grahamshaw1972/TeensyNumPad/README.md

# TeensyNumPad
 Amiga Layout Numpad using Teensy++ 2.0 micro controller. The V1.3 board looks like this when completed and populated with keycaps: 

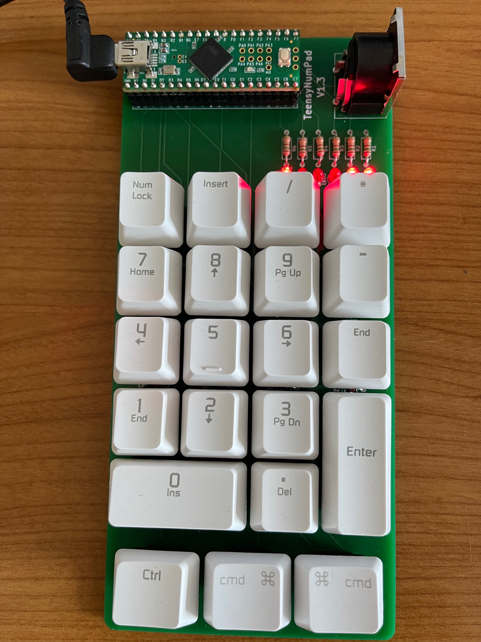
[picture p1: teensyNumPad1_3Assembled.jpg]
