grahamshaw1972/TeensyNumPad/keyboard-layout-editor/keyboard-layout.png

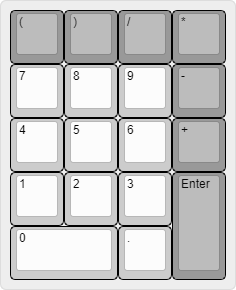
keyboard-layout-editor/keyboard-layout.png
