grahamshaw1972/TeensyNumPad/bom/teensyNumPadBOM.xlsx

Sheet: Mouser
Quantity | Mouser Part Number | References | Value | Footprint
9 | 603-CFR-25JT-52-150R | R1 - R9 | 150 | R_Axial_DIN0207_L6.3mm_D2.5mm_P7.62mm_Horizontal
18 | 512-1N4148 | D1 - D18 | Switching Diode | D_DO-35_SOD27_P7.62mm_Horizontal
1 | 474-DEV-11781 | U1 | Teensy++ 2.0 | D_DO-35_SOD27_P7.62mm_Horizontal
1 | 575-1104764041001000 | U1 | 40 Pin Socket | 40P_2Row_Pitch2.54 mm
9 | 78-TLHK42T1U2 | LED1 - LED9 | Red LED | LED_D3.0mm
21 | 540-MX1A-11NW | MX1 - MX21 | Cherry MX Black | L15.6 mm_W15.6 mm
1 | 806-KCDX-5S-S2 | J1 | 5 Pin Din | KCDX5SS2

Sheet: Other Sources
Quantity | URL | References | Value | Footprint | Notes
1 | https://kbdfans.com/products/cherry-original-pcb-stabilizers | MX16, MX18 | 2u | 2u
1 | https://hobbycomponents.com/connectors/439-01-254mm-40way-sil-turned-pin-m-m-headers-pack-of-5 | U1 | 40 pin | 2 x 20 pin | Cut in half
