grahamshaw1972/TeensyNumPad/teensyNumPadKicad/teensyNumPadKicad.kicad_pcb

## KiCad design teensyNumPadKicad/teensyNumPadKicad.kicad_pcb (2021-06-02)

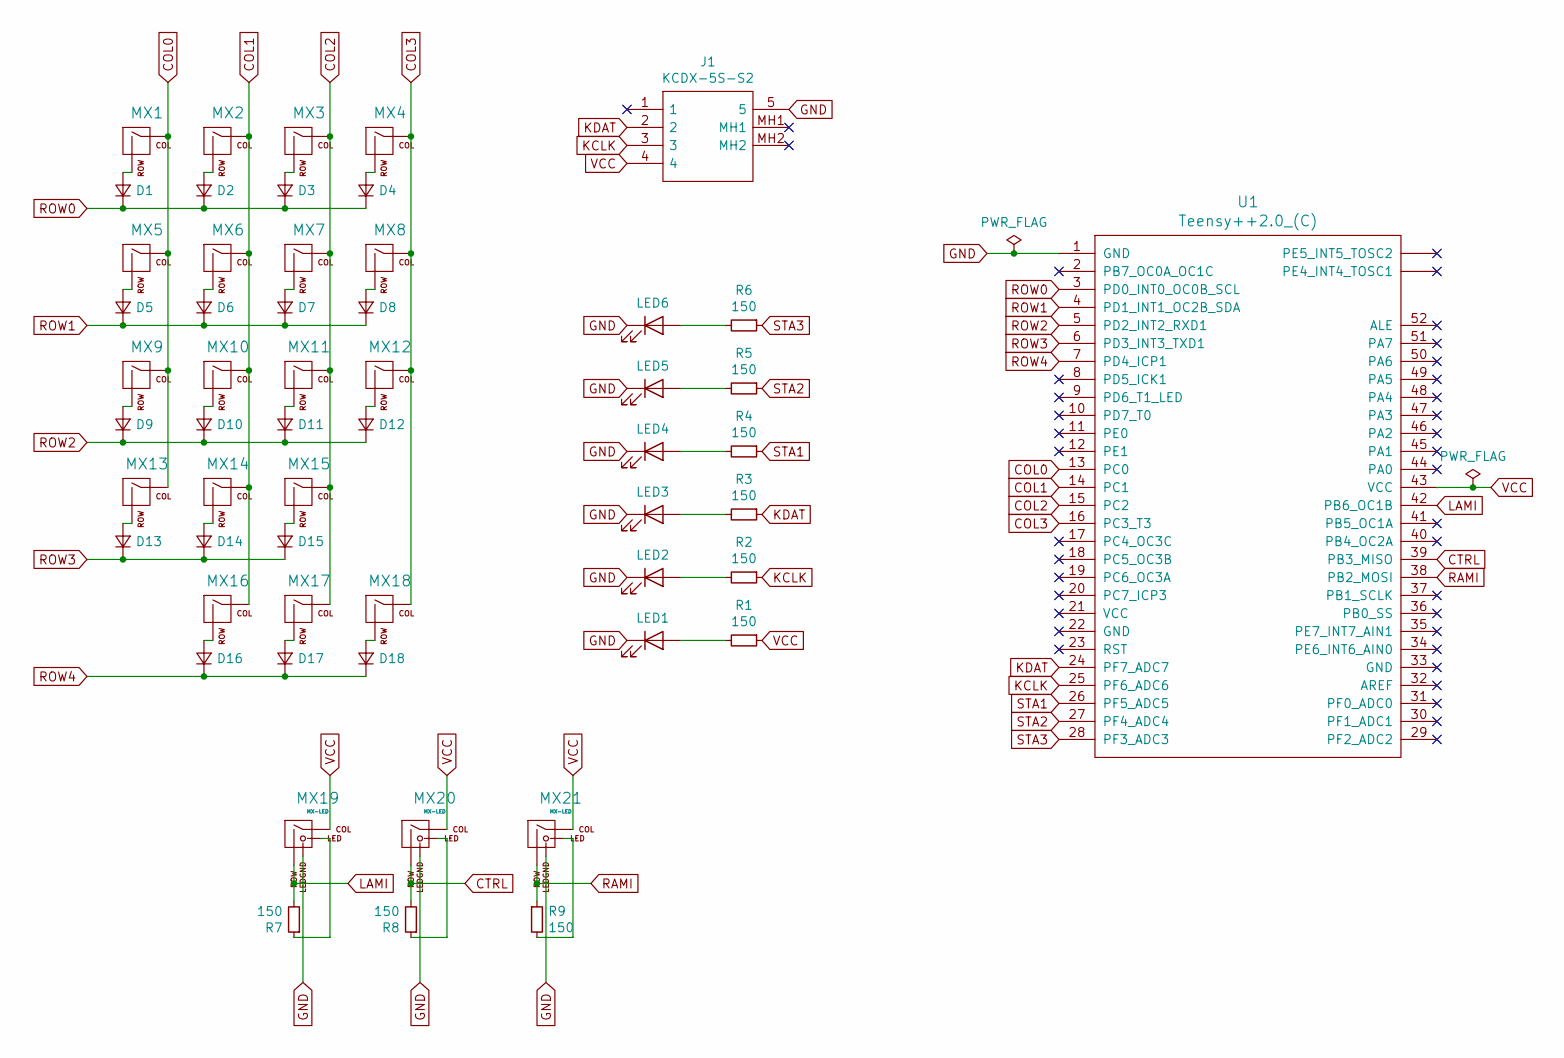
[picture p3: schematic teensyNumPadKicad.sch]

Parts:
D1, D2, D3, D4, D5, D6, D7, D8, D9, D10, D11, D12, D13, D14, D15, D16, D17, D18: D_Small; D_DO-35_SOD27_P7.62mm_Horizontal
J1: KCDX-5S-S2; KCDX5SS2; Manufacturer_Part_Number KCDX-5S-S2
LED1, LED2, LED3, LED4, LED5, LED6: LED; LED_D3.0mm
MX1, MX2, MX3, MX4, MX5, MX6, MX7, MX8, MX9, MX10, MX11, MX12, MX13, MX14, MX15, MX17: MX-NoLED; MX-1U-NoLED
MX16, MX18: MX-NoLED; MX-2U-NoLED
MX19, MX20, MX21: MX-LED; MX-1.25U
R1, R2, R3, R4, R5, R6, R7, R8, R9: 150; R_Axial_DIN0207_L6.3mm_D2.5mm_P10.16mm_Horizontal
U1: Teensy++2.0_(C); Teensy2.0++

Connections:
COL0: MX1.1 (COL), MX5.1 (COL), MX9.1 (COL), MX13.1 (COL), U1.13 (PC0)
COL1: MX2.1 (COL), MX6.1 (COL), MX10.1 (COL), MX14.1 (COL), MX16.1 (COL), U1.14 (PC1)
COL2: MX3.1 (COL), MX7.1 (COL), MX11.1 (COL), MX15.1 (COL), MX17.1 (COL), U1.15 (PC2)
COL3: MX4.1 (COL), MX8.1 (COL), MX12.1 (COL), MX18.1 (COL), U1.16 (PC3_T3)
CTRL: MX20.2 (ROW), R8.2, U1.39 (PB3_MISO)
GND: J1.5, LED1.1 (K), LED2.1 (K), LED3.1 (K), LED4.1 (K), LED5.1 (K), LED6.1 (K), MX19.4 (LEDGND), MX20.4 (LEDGND), MX21.4 (LEDGND), U1.1 (GND)
KCLK: J1.3, R2.1, U1.25 (PF6_ADC6)
KDAT: J1.2, R3.1, U1.24 (PF7_ADC7)
LAMI: MX19.2 (ROW), R7.2, U1.42 (PB6_OC1B)
unnamed: D1.2 (A), MX1.2 (ROW)
unnamed: D2.2 (A), MX2.2 (ROW)
unnamed: D3.2 (A), MX3.2 (ROW)
unnamed: D4.2 (A), MX4.2 (ROW)
unnamed: D5.2 (A), MX5.2 (ROW)
unnamed: D6.2 (A), MX6.2 (ROW)
unnamed: D7.2 (A), MX7.2 (ROW)
unnamed: D8.2 (A), MX8.2 (ROW)
unnamed: D9.2 (A), MX9.2 (ROW)
unnamed: D10.2 (A), MX10.2 (ROW)
unnamed: D11.2 (A), MX11.2 (ROW)
unnamed: D12.2 (A), MX12.2 (ROW)
unnamed: D13.2 (A), MX13.2 (ROW)
unnamed: D14.2 (A), MX14.2 (ROW)
unnamed: D15.2 (A), MX15.2 (ROW)
unnamed: D16.2 (A), MX16.2 (ROW)
unnamed: D17.2 (A), MX17.2 (ROW)
unnamed: D18.2 (A), MX18.2 (ROW)
unnamed: LED1.2 (A), R1.2
unnamed: LED2.2 (A), R2.2
unnamed: LED3.2 (A), R3.2
unnamed: LED4.2 (A), R4.2
unnamed: LED5.2 (A), R5.2
unnamed: LED6.2 (A), R6.2
unnamed: MX19.3 (LED), R7.1
unnamed: MX20.3 (LED), R8.1
unnamed: MX21.3 (LED), R9.2
RAMI: MX21.2 (ROW), R9.1, U1.38 (PB2_MOSI)
ROW0: D1.1 (K), D2.1 (K), D3.1 (K), D4.1 (K), U1.3 (PD0_INT0_OC0B_SCL)
ROW1: D5.1 (K), D6.1 (K), D7.1 (K), D8.1 (K), U1.4 (PD1_INT1_OC2B_SDA)
ROW2: D9.1 (K), D10.1 (K), D11.1 (K), D12.1 (K), U1.5 (PD2_INT2_RXD1)
ROW3: D13.1 (K), D14.1 (K), D15.1 (K), U1.6 (PD3_INT3_TXD1)
ROW4: D16.1 (K), D17.1 (K), D18.1 (K), U1.7 (PD4_ICP1)
STA1: R4.1, U1.26 (PF5_ADC5)
STA2: R5.1, U1.27 (PF4_ADC4)
STA3: R6.1, U1.28 (PF3_ADC3)
VCC: J1.4, MX19.1 (COL), MX20.1 (COL), MX21.1 (COL), R1.1, U1.43 (VCC)

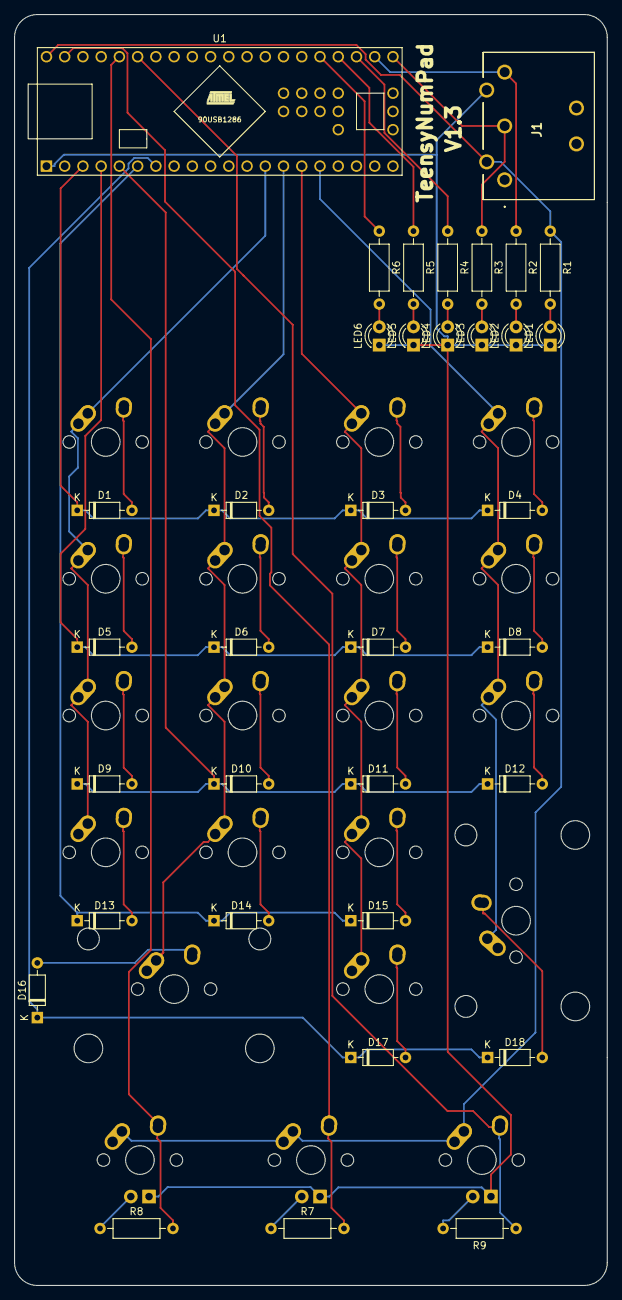
[picture p4: board teensyNumPadKicad.kicad_pcb from above]

Board: 2 copper layers, 82.6 x 177.0 mm, 56 parts (0 on the bottom side), 46 nets.
