grahamshaw1972/TeensyNumPad/keyboard-layout-editor/wiring.PNG

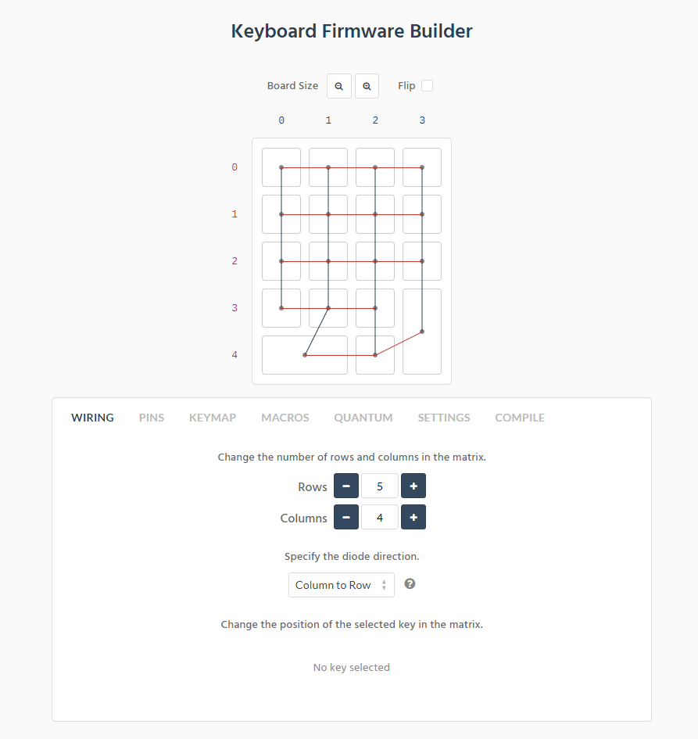
keyboard-layout-editor/wiring.PNG
