grahamshaw1972/TeensyNumPad/firmware/qmk_firmware/keyboards/kb/kb.h

/* Copyright 2021 REPLACE_WITH_YOUR_NAME
 *
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
 * You should have received a copy of the GNU General Public License
 * along with this program.  If not, see <http://www.gnu.org/licenses/>.
 */

#pragma once

#include "quantum.h"

__attribute__((weak)) void matrix_init_user(void);

void amikb_sendkey(unsigned char keycode, int press);
void amikb_wait_for_ack_resync_if_none(void);
void amikb_wait_for_ack_reset_if_none(long timeout);
void wait_for_amiga(long timeout);
void amikb_reset(void);
void hard_reset(void);
void init_timer(void);
void reset_timer(void);
unsigned long get_msec(void);

// ACLK == KCLK == F6
#define ACLK	6
#define ACLK_BIT	(1 << ACLK)

// ADATA == KDAT == F7
#define ADATA	7
#define ADATA_BIT	(1 << ADATA)

#define PIN_CTRL 3
#define CTRL_BIT	(1 << PIN_CTRL)
#define PIN_LAMI 6
#define LAMI_BIT	(1 << PIN_LAMI)
#define PIN_RAMI 2
#define RAMI_BIT	(1 << PIN_RAMI)

#define TIMEOUT_MSEC 143
#define RESET_WARNING_MSEC 250
#define RESET_MSEC 500
#define RESET_WARNING_FULL_MSEC 10000


/*
 * STA3  STA2  STA1  KDAT  KCLK  VCC
 *  F3    F4    F5    F7    F6
 */

#define STA3 F3
#define STA2 F4
#define STA1 F5
#define KDAT F7
#define KCLK F6

#define LAMI B6
#define CTRL B3
#define RAMI B2

#define LAYOUT( \
    K00, K01, K02, K03,   \
    K10, K11, K12, K13,   \
    K20, K21, K22, K23,   \
    K30, K31, K32, K43,   \
    K41,      K42         \
) { \
    { K00,   K01,   K02,   K03   }, \
    { K10,   K11,   K12,   K13   }, \
    { K20,   K21,   K22,   K23   }, \
    { K30,   K31,   K32,   KC_NO }, \
    { KC_NO, K41,   K42,   K43   }, \
}

// Amiga Keycodes
#define AKC_RST_WARN 0x78
#define AKC_PLP 0x5A
#define AKC_PRP 0x5B
#define AKC_PDV 0x5C
#define AKC_PML 0x5D
#define AKC_P7  0x3D
#define AKC_P8  0x3E
#define AKC_P9  0x3F
#define AKC_PMN 0x4A
#define AKC_P4  0x2D
#define AKC_P5  0x2E
#define AKC_P6  0x2F
#define AKC_PPL 0x5E
#define AKC_P1  0x1D
#define AKC_P2  0x1E
#define AKC_P3  0x1F
#define AKC_PEN 0x43
#define AKC_P0  0x0F
#define AKC_PDT 0x3C

extern unsigned char amiga_keycode_table[MATRIX_ROWS][MATRIX_COLS];

// generated by KBFirmware JSON to QMK Parser
// https://noroadsleft.github.io/kbf_qmk_converter/
