grahamshaw1972/TeensyNumPad/(commit log)

2021-04-17 Added keyboard-layout-editor and kicad directories
    [teensyNumPadKicad.kicad_pcb, teensyNumPadKicad.sch]
2021-04-17 Added Symbol and Footprint libraries
2021-04-19 Added Gerbers file and ibom.html
    [teensyNumPadKicad.kicad_pcb]
2021-05-01 Add teensyNumPadPCB.jpg and link to it in README.md
2021-05-03 Add 5 pin din plug for connection to an Amiga
    [teensyNumPadKicad.kicad_pcb, teensyNumPadKicad.sch]
2021-05-08 Add Modifier keys + LEDs
    [teensyNumPadKicad.kicad_pcb, teensyNumPadKicad.sch]
2021-05-08 Create new gerber files
    [teensyNumPadKicad.kicad_pcb]
2021-05-08 Update teensyNumPadKicad.kicad_pcb-bak
2021-05-12 Update Firmware with correct Numpad Keycodes
    [teensyNumPadBOM.xlsx]
2021-05-15 Move diodes for 2u keys
    Diode was clashing with stabilizer
    [teensyNumPadKicad.kicad_pcb]
2021-06-02 Updated Schema and PCB
    Fixed pin assignments on 5 pin DIN socket as follows:
    1 Not Connected
    2 KDAT
    3 KCLK
    4 +5V
    5 GND
    This is because the pins are numbered from right to left rather than left to right. Also increased the size of the resistor footprints.
    [teensyNumPadKicad.kicad_pcb, teensyNumPadKicad.sch]
2021-06-02 Update output files
    gerberFiles.zip & ibom.html
2021-06-02 Update picture in readme.md
    Include picture of v1.2 assembled.
2021-06-02 Update to use MX-LED footprints where required
    Use MX-LED footprints for MX-19, MX20 + MX21.
    [teensyNumPadKicad.kicad_pcb, teensyNumPadKicad.sch]
2021-06-20 Add qmk-firmware
    [nose2.cfg]
2021-06-20 Light LED in response to key press.
2021-06-20 Update to use standard pin expressions
    Such as writePinHigh(F5)
2021-06-27 Amiga now starts
    Set KCLK to high on start up -> A2000 now starts up with Teensy Numpad connected.
    #define NO_USB_STARTUP_CHECK 1
    This is so that keyboard_task() gets called as required when connected to an A2000.
2021-06-27 Update README.md
    Upddate picture to teensyNumPad1_3Assembled.jpg
2021-06-27 Now sends keycode to Amiga
    Bug where only one key is received by Amiga before we get a blank screen.
    [kb.c, kb.h]
2021-06-27 Move timer functions into kb.c
2021-06-30 Fixed the locking up bug
    Needed to raise the clock high after the handshake. Main keypad keys are now all working. Crtl, L-Amiga + R-Amiga are not yet implemented.
    [kb.c]
2021-07-03 Add reset code
    Hard reset only.
    [kb.c, kb.h]
2021-07-03 Added reset warnings
    Implemented but difficult to test TBH.
    [config.h, kb.c, kb.h]
2021-07-04 Make sending of reset warning configurable using a #define
    #ifdef SEND_RESET_WARNING
    [kb.c]
